nve03g/BAP_groep_3/circuit_CAM.pdf

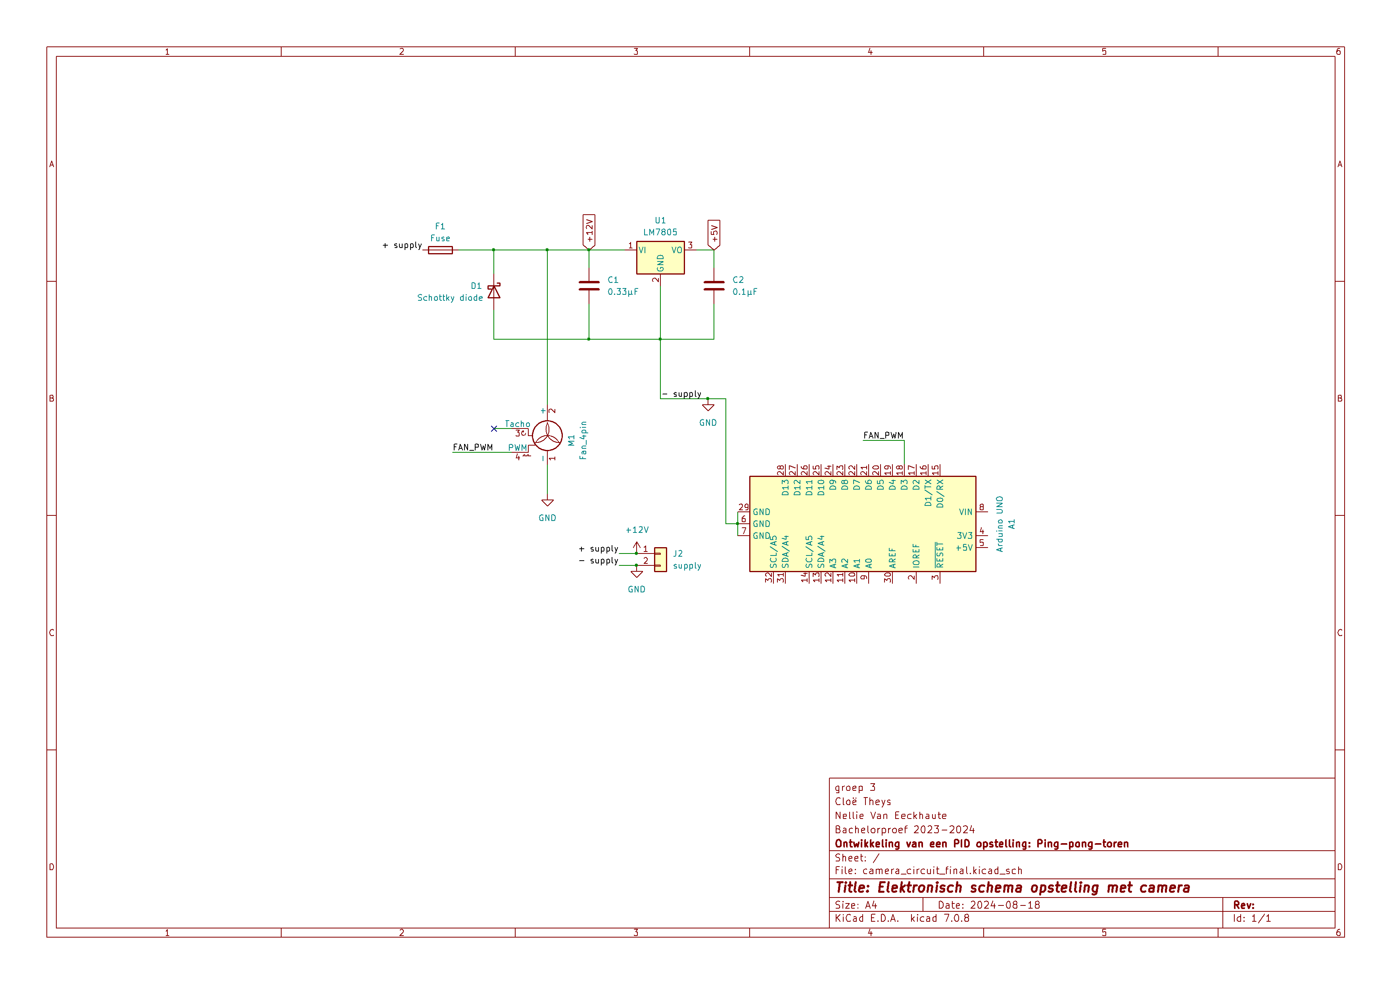
[picture p9: page 1]
