nve03g/BAP_groep_3/circuit_ToF.pdf

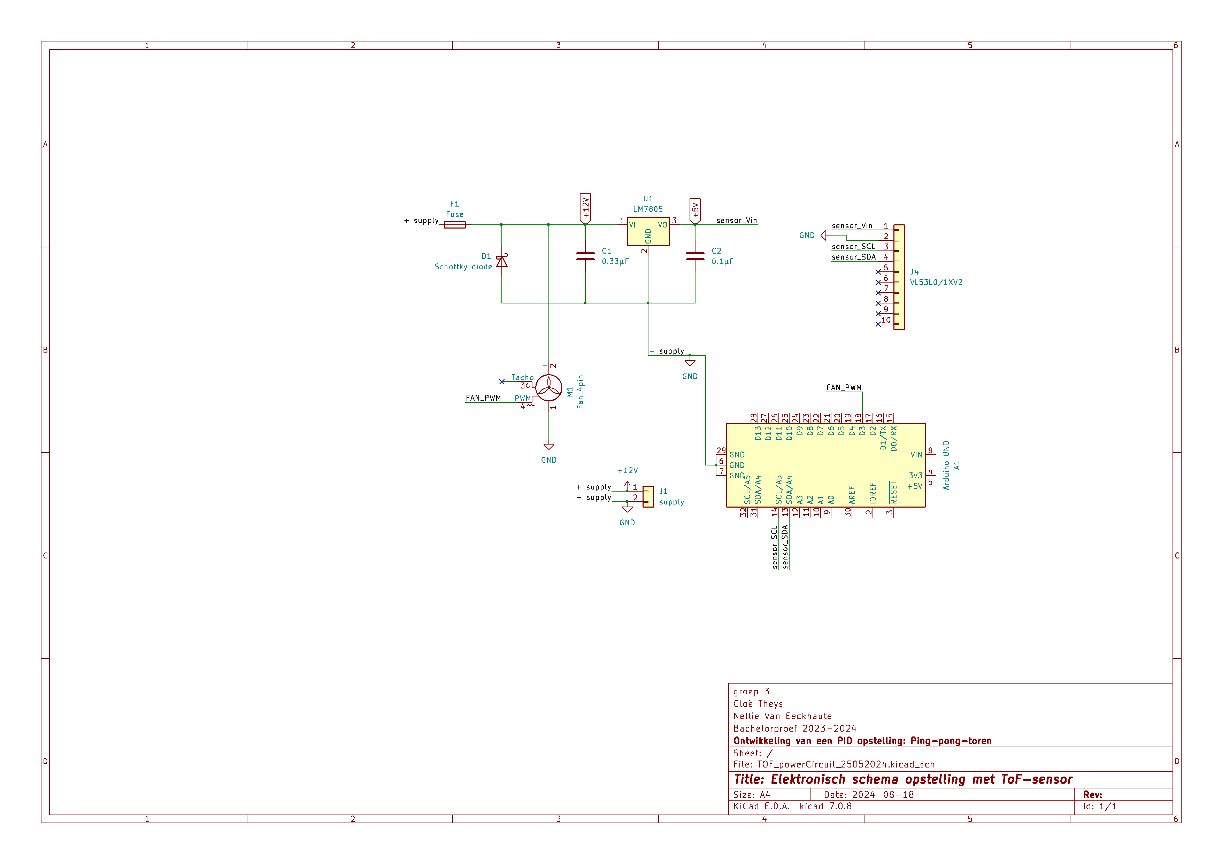
[picture p10: page 1]
