nve03g/BAP_groep_3/code_CAM/Python/Background_cam.PNG

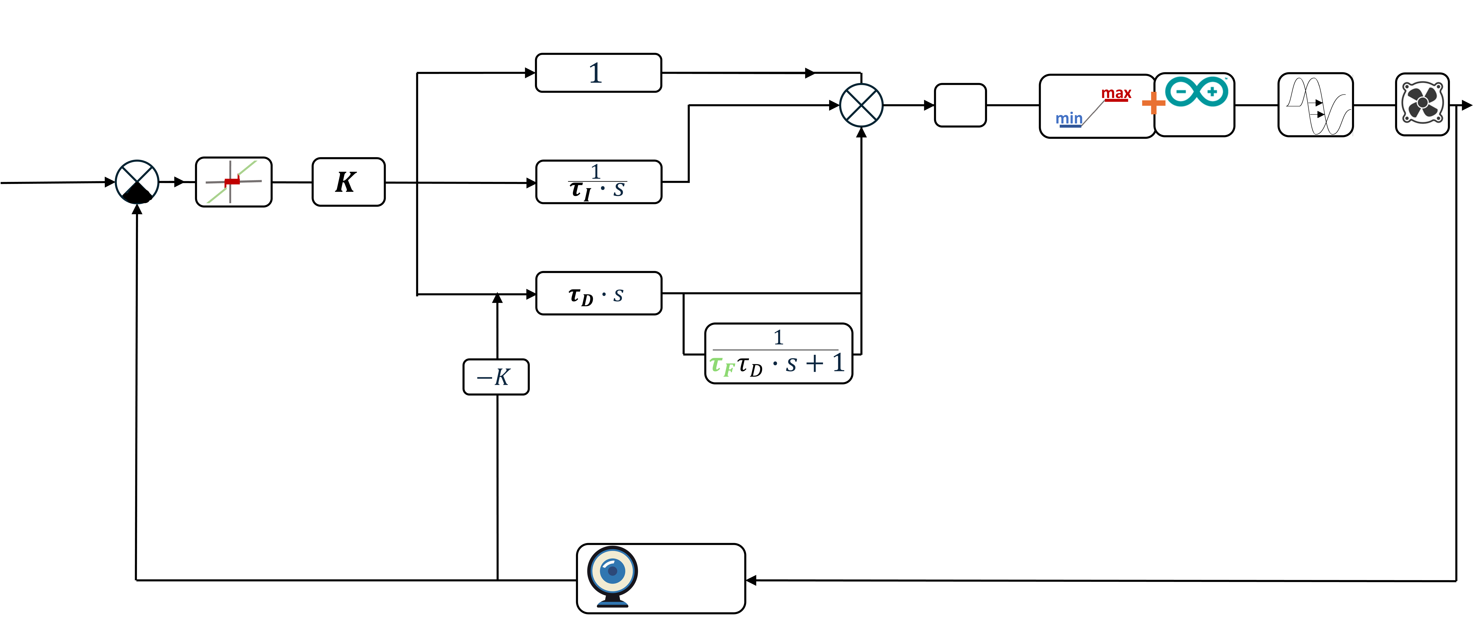
code_CAM/Python/Background_cam.PNG
