nve03g/BAP_groep_3/code_CAM/Python/open_vertical.png

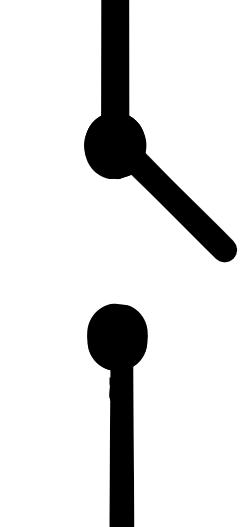
code_CAM/Python/open_vertical.png
