nve03g/BAP_groep_3/(list of files, cad)

Other CAD files:
Inventor_FINAL_8AUG24/Knoptsnstuk_8AUG.ipt
Inventor_FINAL_8AUG24/Tussen30_AUG.ipt
Inventor_FINAL_8AUG24/Tussen60_8AUG.ipt
Inventor_FINAL_8AUG24/bovenstuk_8AUG.ipt
Inventor_FINAL_8AUG24/onderstuk_8AUG.ipt
