nve03g/BAP_groep_3/code_CAM/Python/config.ini

[Camera]
fps = 30
camera_no = 0
platforms_length = 43.0
pix_minpos = 361.77398681640625
pix_maxpos = 1799.0
hsv_upperbound = [ 45 157 255]
hsv_lowerbound = [  1  61 255]
l_h = 1
l_s = 61
l_v = 255
u_h = 45
u_s = 157
u_v = 255

[System]
neutral angle = 0
minimum_pwm = 22
maximum_pwm = 35
deadtime_fans = 0.19
com_port = COM10
baudrate = 115200

[PID]
deadband_error = 1.0
k = 3.6471
ti = 0.242
td = 0.06
deadband_angle = 0
tf_factor = 0.0
i_active = 0
d_active = 0
d_kick_active = False
lpf_filter = False
open_loop = True
