nve03g/BAP_groep_3/(commit log)

2024-08-18 cleaned up electronic circuits
2024-08-18 cleaned up codes (Arduino and Python)
2024-08-18 added Inventor files of the ping-pong-setup
    [Knoptsnstuk_8AUG.ipt, Tussen30_AUG.ipt, Tussen60_8AUG.ipt, bovenstuk_8AUG.ipt, onderstuk_8AUG.ipt]
